AveryLor/oscilloscope-dev/README.md

# Oscilloscope

FPGA + ESP32 firmware for an oscilloscope: the Tang Nano 20K buffers ADC samples; an ESP32 streams them to a laptop for display.

## Hardware

- Sipeed Tang Nano 20K (GW2AR-18C) — [datasheet](https://dl.sipeed.com/shareURL/TANG/Nano_20K/1_Datasheet)
- ESP32 DevKit V1 (Elegoo, ESP-WROOM-32) (laptop link)

## System architecture

Mermaid flowchart of ADC capture flow from the schematics.

```mermaid
flowchart LR
  ADC[AD9215_D0_D9_OR] --> FPGA
  Clk[PL133_FPGA_CLK] --> FPGA
  EncH[HS_HO_TG_encoders] --> FPGA
  Probe[PROBE_COMP] --> FPGA
  ESP32 -->|"HSPI VGA_MOSI SDIO"| VGA[LMH6518]
  Dac[MCP4726_I2C] --> ESP32
  Relays[atten_term_coupling] --> ESP32
  EncV[VS_VO_encoders] --> ESP32
  ESP32 -->|"VSPI FPGA_MOSI cmds"| FPGA
  FPGA -->|"VSPI FPGA_MISO samples"| ESP32
  ESP32 -->|"USB_UART frames"| PC[Python GUI]
  PC -->|"USB_UART cmds"| ESP32
```

| Block | Role |
| --- | --- |
| **ESP32** | VGA, LNA DAC, relays, vertical knobs, SPI master, stream frozen captures over USB-UART |
| **FPGA**  | 100 Msps capture (`ADC_D*` + `FPGA_CLK`), SPI slave dump |
| **GUI** | Draws the trace, graticule and readout from the streamed captures; sends dial/toggle control commands back to the ESP32 |

## PCB View

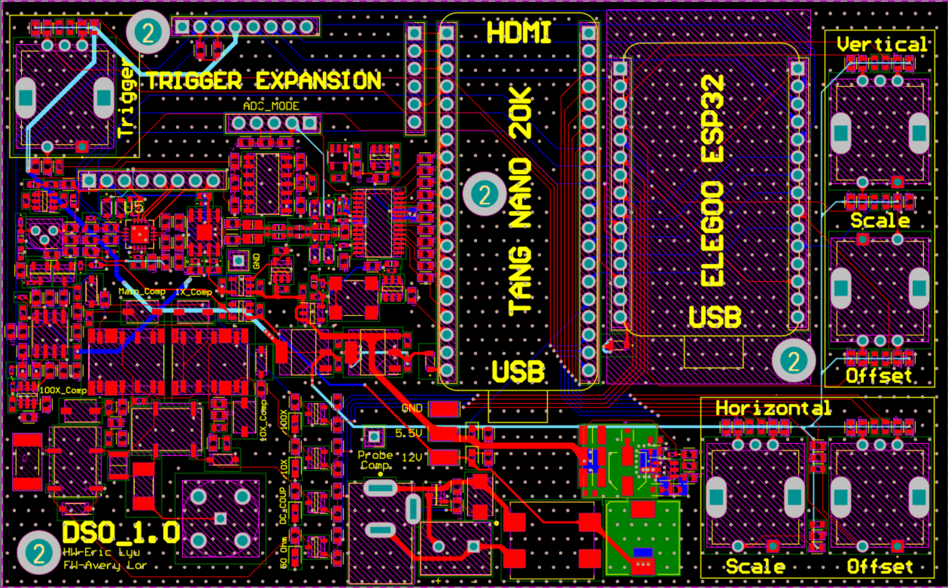
[picture p1: docs/oscilliscope-pcb-view.png]
Osciliscope PCB View


## 3D View

Osciliscope 3D View

## Pinout

### ESP32 (DevKit V1, Elegoo ESP-WROOM-32)

J9 is the left header (EN side), J10 the right (D23 side). Pin 1 is at the antenna end.

| Header | Net | GPIO | Silk Screen | Why |
| --- | --- | ---- | --- | --- |
| J9-1 | `ESP_EN` | — | EN | Chip enable, active-high |
| J9-2 | `DIAL_VS_A` | 36 | VP | Input-only |
| J9-3 | `DIAL_VS_B` | 39 | VN | Input-only |
| J9-4 | `DIAL_VO_A` | 34 | D34 | Input-only. **`pins.h` has 35** |
| J9-5 | `DIAL_VS_BTN` | 35 | D35 | Input-only. **`pins.h` has 34** |
| J9-6 | `100X_10X` | 32 | D32 | Relay FET |
| J9-7 | `10X_1X` | 33 | D33 | Relay FET |
| J9-8 | `DC_COUP` | 25 | D25 | Relay FET |
| J9-9 | `50_OHM_TERM` | 26 | D26 | Relay FET |
| J9-10  | `ESP_FLEX_3`  | 27 | D27 | J4 trigger mezzanine |
| J9-11  | `VGA_SCLK` | 14 | D14 | `HSPICLK` → `LMH6518SQ` |
| J9-12  | — | 12 | D12 | Not connected (strapping pin) |
| J9-13  | `VGA_MOSI` | 13 | D13 | `HSPID` → `LMH6518SQ` SDIO, writes only |
| J9-14  | GND | — | GND | Common ground |
| J9-15  | 5V | — | VIN | +5 through Schottky `D13` |
| J10-1  | `FPGA_MOSI` | 23 | D23 | `VSPID` → FPGA commands |
| J10-2  | `SCL` | 22 | D22 | Hardware I2C (`VSPIWP` unused) |
| J10-3  | `ESP_FLEX_1`  | 1 | TX0 | J4 trigger mezzanine. **Shares UART0 (USB serial)** |
| J10-4  | `ESP_FLEX_2`  | 3 | RX0 | J4 trigger mezzanine. **Shares UART0 (USB serial)** |
| J10-5  | `SDA` | 21 | D21 | Hardware I2C (`VSPIHD` unused) |
| J10-6  | `FPGA_MISO` | 19 | D19 | `VSPIQ` ← FPGA sample dump |
| J10-7  | `FPGA_SCLK` | 18 | D18 | `VSPICLK` → FPGA J6-13 |
| J10-8  | `FPGA_CS` | 5 | D5 | `VSPICS0` → FPGA J6-14, idle-high |
| J10-9  | `DIAL_VO_B` | 17 | TX2 | Vertical offset encoder B |
| J10-10 | `FPGA_IRQ` | 16 | RX2 | Capture-ready from FPGA J6-6; active-high, needs internal pull-down |
| J10-11 | `DIAL_VO_BTN` | 4 | D4 | Vertical offset button |
| J10-12 | — | 2 | D2 | Not connected (strapping pin) |
| J10-13 | `VGA_CS` | 15 | D15 | `HSPICS0` → `LMH6518SQ`, idle-high |
| J10-14 | GND | — | GND | Common ground |
| J10-15 | — | — | 3V3 | Not connected |

### FPGA (Tang Nano 20K)

| Header | Net | FPGA pin | Nano silk | Why |
| --- | --- | --- | --- | --- |
| J6-1 | GND | — | GND | Common ground |
| J6-2 | 3V3 | — | 3V3 | I/O rail |
| J6-3 | — | 18 | `IOL49B` / LED3 | Spare |
| J6-4 | — | 19 | `IOL51A` / LED4 | Spare |
| J6-5 | — | 20 | `IOL51B` / LED5 | Spare |
| J6-6 | `FPGA_IRQ` | 17 | `IOL49A` / LED2 | Capture-ready → ESP32; active-high, idle low |
| J6-7 | `PROBE_COMP` | 31 | `IOB29A` / LCD_B3 | Cal square; also J8-2 |
| J6-8 | `DIAL_TG_BTN` | 30 | `IOB14B` / LCD_B4 | Trigger encoder button |
| J6-9 | `DIAL_TG_B` | 29 | `IOB14A` / LCD_B5 | Trigger encoder B |
| J6-10  | `DIAL_TG_A` | 26 | `IOB6B` / LCD_VS | Trigger encoder A |
| J6-11  | `FPGA_SPI_MOSI` | 25 | `IOB6A` / LCD_HS | VSPI MOSI: ESP32 commands |
| J6-12  | `FPGA_SPI_MISO` | 28 | `IOB8B` / LCD_B6 | VSPI MISO: frozen sample dump |
| J6-13  | `FPGA_SPI_SCLK` | 27 | `IOB8A` / LCD_B7 | VSPI clock |
| J6-14  | `FPGA_SPI_CS` | 16 | `IOL47B` / LED1 | VSPI CS, idle-high |
| J6-15  | `DIAL_HS_B` | 15 | `IOL47A` / LED0 | Horizontal scale encoder B |
| J6-16  | `DIAL_HS_A` | 77 | `IOT30A` / LCD_CLK | Horizontal scale encoder A |
| J6-17  | `DIAL_HS_BTN` | 85 | `IOT4B` / SDIO_D1 | Horizontal scale button |
| J6-18  | `DIAL_HO_A` | 75 | `IOT34A` / HSPI_DIR | Horizontal offset encoder A |
| J6-19  | `DIAL_HO_B` | 74 | `IOT34B` / HSPI_DIN3 | Horizontal offset encoder B |
| J6-20  | `DIAL_HO_BTN` | 73 | `IOT40A` / HSPI_DIN2 | Horizontal offset button |
| J7-1 | `FPGA_FLEX_3` | 52 | `IOR39A` / BL616_UART_RX | J4 trigger mezzanine |
| J7-2 | `FPGA_FLEX_2` | 53 | `IOR38B` / EDID_CLK | J4 trigger mezzanine |
| J7-3 | `FPGA_FLEX_1` | 71 | `IOT44A` / HSPI_DIN0 | J4 trigger mezzanine |
| J7-4 | `HW_TRIGGER` | 72 | `IOT40B` / HSPI_DIN1 | Digital trigger in from J4 |
| J7-5 | 3V3 | — | 3V3 | I/O rail |
| J7-6 | GND | — | GND | Common ground |
| J7-7 | `ADC_OR` | 79 | `IOT27B` / `GCLKC_0` / 2812_DIN | Overflow |
| J7-8 | `ADC_D9` | 86 | `IOT4A` / HSPI_CSN | MSB of the parallel bus |
| J7-9 | `ADC_D8` | 49 | `IOR49A` / LCD_BL | Consecutive down J7 |
| J7-10  | `ADC_D7` | 55 | `IOR36B` / I2S_LRCK | Consecutive |
| J7-11  | `ADC_D6` | 48 | `IOR49B` / LCD_DE | Consecutive |
| J7-12  | `ADC_D5` | 51 | `IOR45A` / PA_EN | Consecutive |
| J7-13  | `ADC_D4` | 54 | `IOR38A` / I2S_DIN | Consecutive |
| J7-14  | `ADC_D3` | 56 | `IOR36A` / I2S_BCLK | Consecutive |
| J7-15  | `ADC_D2` | 41 | `IOB43A` / LCD_R4 | Consecutive |
| J7-16  | `ADC_D1` | 42 | `IOB42B` / LCD_R3 | Consecutive |
| J7-17  | `ADC_D0` | 80 | `IOT27A` / SDIO_D2 | LSB |
| J7-18  | `FPGA_CLK` | 76 | `IOT30B` / `GCLKC_1` | 100 MHz from PL133 via 30 Ω (`R51`) |
| J7-19  | GND | — | GND | Common ground |
| J7-20  | 5V | — | 5V | Through Schottky `D12`; do not back-power blindly |

## Repository layout

| Path | Role |
| --- | --- |
| `fpga/rtl/` | Tang Nano 20K RTL: capture datapath, trigger, ring buffer, SPI slave, encoders |
| `fpga/sim/` | Icarus Verilog test benches (`make -C fpga sim`) |
| `fpga/constr/` | `.cst` pin map, `.sdc` timing |
| `fpga/build/` | Gowin `gw_sh` build script |
| `esp32/` | ESP-IDF firmware: AFE control + `fpga_link.c` SPI-master driver + streamer |
| `gui/` | Python host display + control (`oscilloscope-gui --port /dev/ttyUSB0`, PySide6 + pyqtgraph) |
| `docs/PROTOCOL.md` | ESP32 ↔ FPGA SPI register contract (shared by `scope_regs.svh` / `scope_proto.h`) |
| `docs/STREAM.md` | ESP32 → host sample-stream format (shared by `stream_frame.h` / `frame.py`) |
| `docs/CONTROL.md`  | Host → ESP32 control-command format (shared by `cmd_parse.h` / `control.py`) |

## Build

**FPGA** (needs [Gowin EDA](https://www.gowinsemi.com/) `gw_sh` and [openFPGALoader](https://github.com/trabucayre/openFPGALoader)):

```bash
make -C fpga/ build
make -C fpga/ prog
```

**FPGA simulation** (needs [Icarus Verilog](https://steveicarus.github.io/iverilog/)):

```bash
make -C fpga/ sim            # run every bench
make -C fpga/sim tb_top      # one bench; WAVES=1 also writes build/<name>.vcd
```

**ESP32** (needs [ESP-IDF](https://docs.espressif.com/projects/esp-idf/)):

```bash
cd esp32
idf.py set-target esp32
idf.py build
idf.py flash
```

Do not leave `idf.py monitor` attached while the GUI is running — the sample
stream and the monitor share UART0, and only one process can hold the port.

The framing, column-reduction, and control-command-parsing logic all build
without ESP-IDF, so they can be tested with just a C compiler:

```bash
make -C esp32/test
```

**Host GUI** (needs [Python](https://www.python.org/) >= 3.10):

```bash
cd gui
python -m venv .venv && source .venv/bin/activate
pip install -e ".[dev]"
oscilloscope-gui --list                  # show serial ports
oscilloscope-gui --port /dev/ttyUSB0
pytest                                   # includes the C-interop format check
```

To try the GUI without hardware, stream a fake sine wave (needs `socat`):

```bash
./gui/tools/run-fake-scope.sh --freq 2 --amplitude 300
```

## Branch protection (`main`)

Direct pushes and force pushes to `main` are not allowed. Work on a branch and open a pull request:

```bash
git checkout -b my-change
git push -u origin HEAD
# open a PR into main, then merge on GitHub
```

Enforcement is a GitHub **repository ruleset** (not Actions alone). The policy lives in [`.github/rulesets/main.json`](.github/rulesets/main.json).

### One-time ruleset setup

1. Create a fine-grained PAT with **Administration: Read and write** for this repository.
2. Add it as a repository secret named `RULESET_TOKEN`.
3. Run the **Apply main ruleset** workflow (`workflow_dispatch`), or apply locally:

```bash
export RULESET_TOKEN=...   # same PAT
export GITHUB_REPOSITORY=AveryLor/oscilloscope-dev
./.github/scripts/apply-main-ruleset.sh
```

Repository admins can bypass the ruleset for break-glass only. [`.github/workflows/guard-main.yml`](.github/workflows/guard-main.yml) also fails the Actions run if a forced push to `main` is ever observed.
