AveryLor/oscilloscope-dev/fpga/sim/models/rPLL.v

/*
 * File: rPLL.v
 * Description: Behavioral stand-in for the Gowin rPLL primitive, enough for
 *              simulating adc_pll / top under Icarus. CLKOUTP follows CLKIN 1:1
 *              with a fixed phase offset; LOCK asserts after a short delay. Not
 *              cycle-accurate to the real PLL and only models the ports adc_pll
 *              actually uses.
 * Author: Avery Lor
 * Date: Aug 30 2026
 */

`timescale 1ns/1ps

module rPLL #(
    parameter FCLKIN            = "100",
    parameter DYN_IDIV_SEL      = "false",
    parameter IDIV_SEL          = 0,
    parameter DYN_FBDIV_SEL     = "false",
    parameter FBDIV_SEL         = 0,
    parameter DYN_ODIV_SEL      = "false",
    parameter ODIV_SEL          = 8,
    parameter PSDA_SEL          = "0000",
    parameter DYN_DA_EN         = "false",
    parameter DUTYDA_SEL        = "1000",
    parameter CLKOUT_FT_DIR     = 1'b1,
    parameter CLKOUTP_FT_DIR    = 1'b1,
    parameter CLKOUT_DLY_STEP   = 0,
    parameter CLKOUTP_DLY_STEP  = 0,
    parameter CLKFB_SEL         = "internal",
    parameter CLKOUT_BYPASS     = "false",
    parameter CLKOUTP_BYPASS    = "false",
    parameter CLKOUTD_BYPASS    = "false",
    parameter DYN_SDIV_SEL      = 2,
    parameter CLKOUTD_SRC       = "CLKOUT",
    parameter CLKOUTD3_SRC      = "CLKOUT",
    parameter DEVICE            = "GW2AR-18C"
) (
    output CLKOUT,
    output LOCK,
    output CLKOUTP,
    output CLKOUTD,
    output CLKOUTD3,
    input  RESET,
    input  RESET_P,
    input  CLKIN,
    input  CLKFB,
    input  [5:0] FBDSEL,
    input  [5:0] IDSEL,
    input  [5:0] ODSEL,
    input  [3:0] PSDA,
    input  [3:0] DUTYDA,
    input  [3:0] FDLY
);

    // CLKOUTP lags CLKIN by PSDA_SEL * 22.5 deg of one 100 MHz period
    // (10 ns). PSDA_SEL is a 4-char "0"/"1" string, MSB first.
    localparam integer PSDA_STEPS = ((PSDA_SEL[31:24] == "1") ? 8 : 0)
                                  + ((PSDA_SEL[23:16] == "1") ? 4 : 0)
                                  + ((PSDA_SEL[15:8]  == "1") ? 2 : 0)
                                  + ((PSDA_SEL[7:0]   == "1") ? 1 : 0);
    // Plus the PLL + clock-route insertion delay to the ADC pad flops that the
    // Gowin timing report shows (3.65 ns PLL + 1.51 ns route).
    localparam real INSERTION_NS = 5.163;
    localparam real PHASE_NS = INSERTION_NS + 10.0 * PSDA_STEPS / 16.0;

    assign CLKOUT   = CLKIN;
    // Transport delay: PHASE_NS exceeds half a period, which an inertial
    // `assign #` delay would swallow.
    reg clkoutp_r = 1'b0;
    always @(CLKIN) clkoutp_r <= #(PHASE_NS) CLKIN;
    assign CLKOUTP = clkoutp_r;
    assign CLKOUTD   = 1'b0;
    assign CLKOUTD3  = 1'b0;

    reg locked = 1'b0;
    initial begin
        #200 locked = 1'b1;
    end
    assign LOCK = locked & ~RESET & ~RESET_P;

endmodule
