AveryLor/oscilloscope-dev/(commit log)

2026-08-03 esp32 initialization of build system
2026-08-14 2.5 volt logic level
2026-08-14 current pin configuration
2026-08-15 commiting current pinout
2026-08-15 updated FPGA pinout to match that of the esp32
2026-08-29 drivers for adc and vga
2026-08-29 added lmh driver include
2026-08-31 spi fpga control, defined internal register structure and driver for esp32
2026-08-31 adc acquisition state machine
2026-08-31 adc inversion logic
2026-08-31 esp32 trigger
2026-08-31 probe comp pin gen
2026-08-31 internal SPI registers for the fpga spi controller
2026-08-31 spi register file protocol (decoder and encoder)
2026-08-31 spi byte engine
2026-08-31 power on reset
2026-09-23 added emit frame
2026-10-04 Add run-fake-scope.sh to launch GUI against a fake sine stream
    Wraps the socat pty pair, fake_scope.py, and oscilloscope-gui into one
    command so the GUI can be exercised without ESP32 hardware.
